Jack-liu1998/Non-contact-current-detector/TIM图片20180824213353.jpg

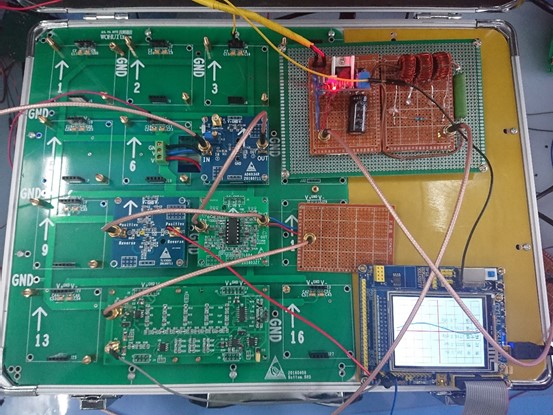
TIM图片20180824213353.jpg
