Jack-liu1998/Non-contact-current-detector/原理图/AD603原理图_v2.pdf

### 输出控制在0-1V

### 60MHz,40db，低噪声、宽增益可调集成运放

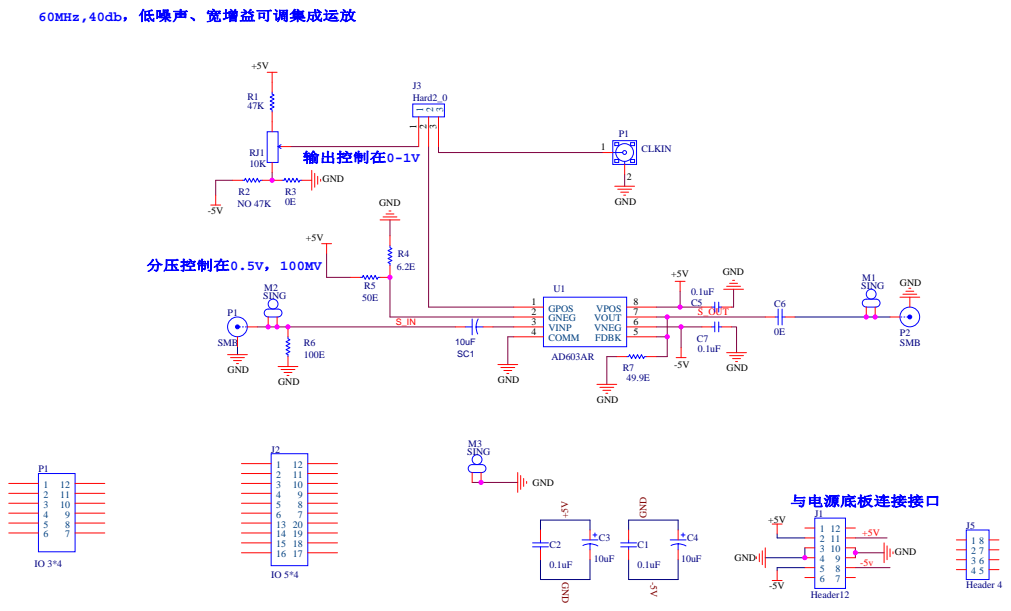
[picture p20: page 1]
