Jack-liu1998/Non-contact-current-detector/原理图/RC有源低通滤波器_TL084_工程文件.pdf

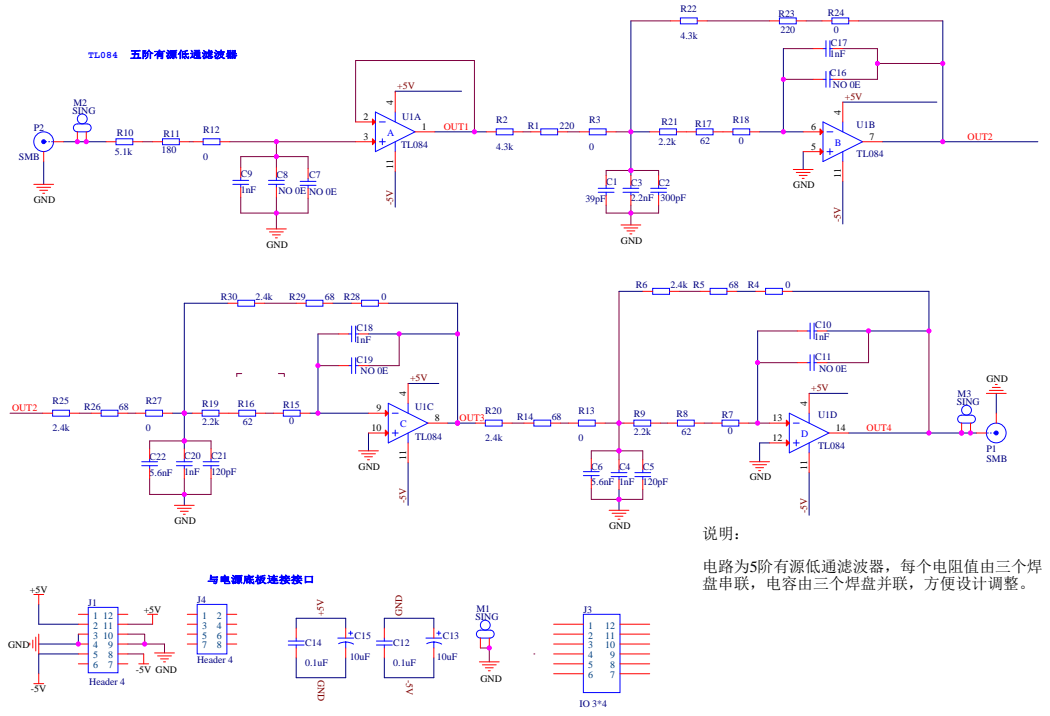
[picture p21: page 1]

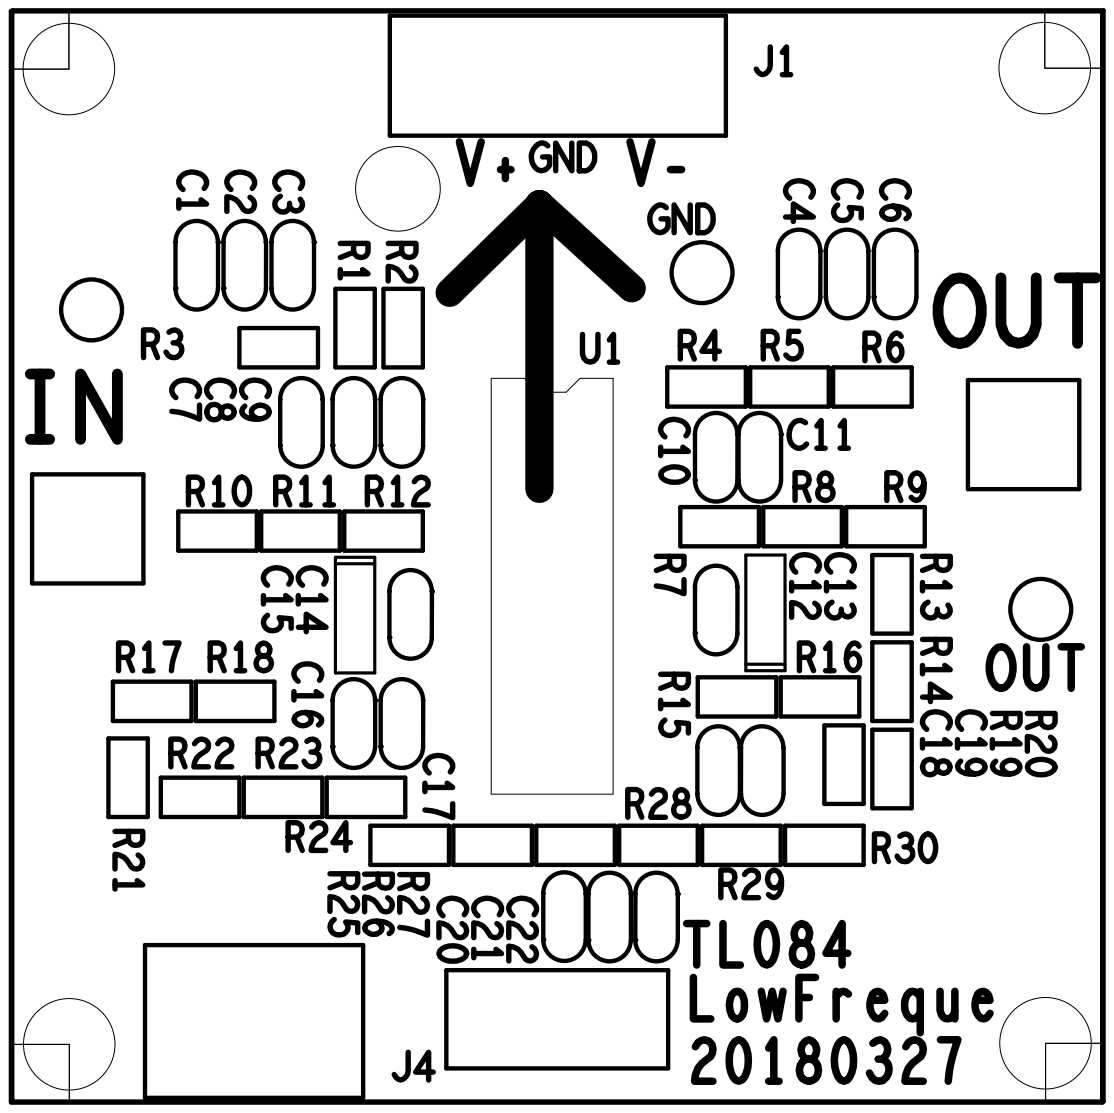
[picture p22: page 2]

封装 | 名称 | 数量 | 标号 | 备注
0805C | 39pF | 1 | C1
0805C | 300pF | 1 | C2
0805C | 2.2nF | 1 | C3
0805C | 1nF | 6 | C4;C9;C10;C17;C18;C20
0805C | 120pF | 2 | C5;C21
0805C | 5.6nF | 2 | C6;C22
0805C | 0 | 5 | C7;C8;C11;C16;C19 | 不焊
0805C | 0.1uF | 2 | C12;C14
0805R | 220 | 2 | R1;R23
0805R | 4.3k | 2 | R2;R22
0805R | 0 | 10 | R3;R4;R7;R12;R13;R15;R18;R24;R27;R28
0805R | 68 | 4 | R5;R14;R26;R29
0805R | 2.4k | 4 | R6;R20;R25;R30
0805R | 62 | 3 | R8;R16;R17
0805R | 2.2k | 3 | R9;R19;R21
0805R | 5.1k | 1 | R10
0805R | 180 | 1 | R11
3216T | 10uF | 2 | C13;C15
DIP4 | Header 4 | 1 | J4
DIP6 | Header 4 | 1 | J1
SMA-2 | SMB | 2 | P1;P2
TL084 | TL084 | 1 | U1
