Jack-liu1998/Non-contact-current-detector/原理图/stm32开发板.pdf

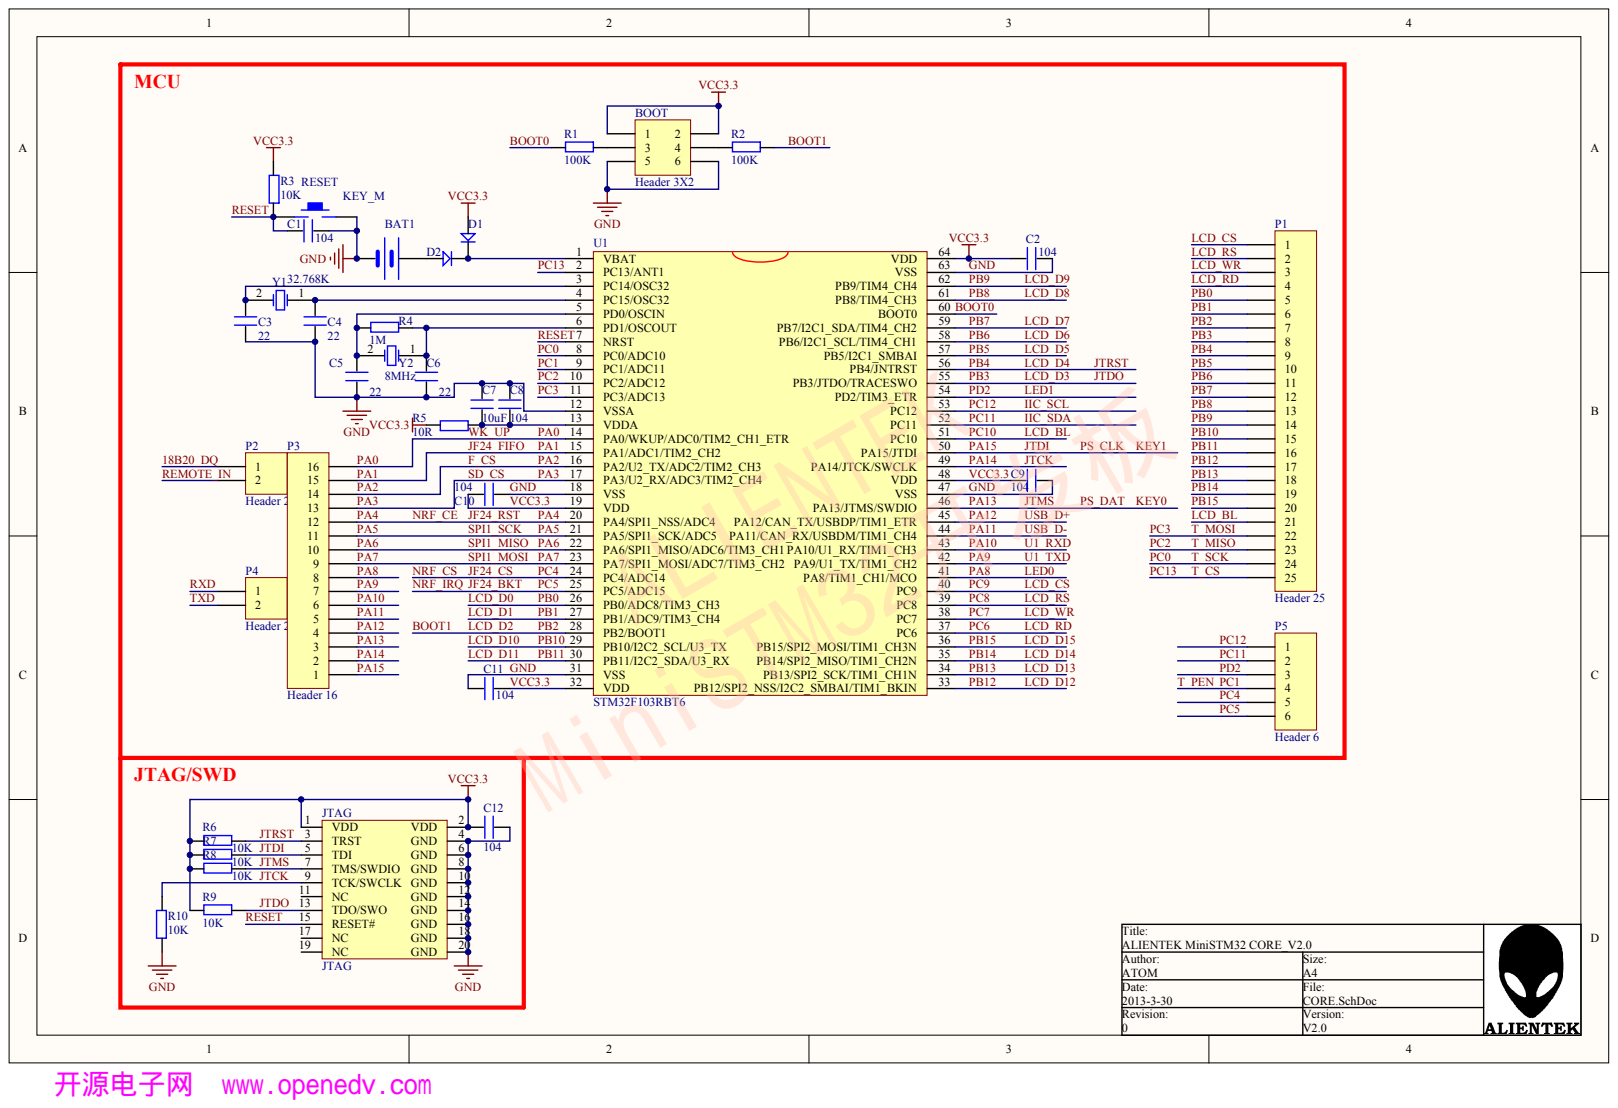
[picture p23: page 1]

PC15/OSC32 4

PD1/OSCOUT 6

8MHz | C6 | PC1/ADC11 9 PC2/ADC12 10 PC3/ADC13 11 VSSA 12

Author: ATOM | Size: A4

Date: 2013-3-30 | File: CORE.SchDoc

Revision: 0 | Version: V2.0

开源电子网 www.openedv.com

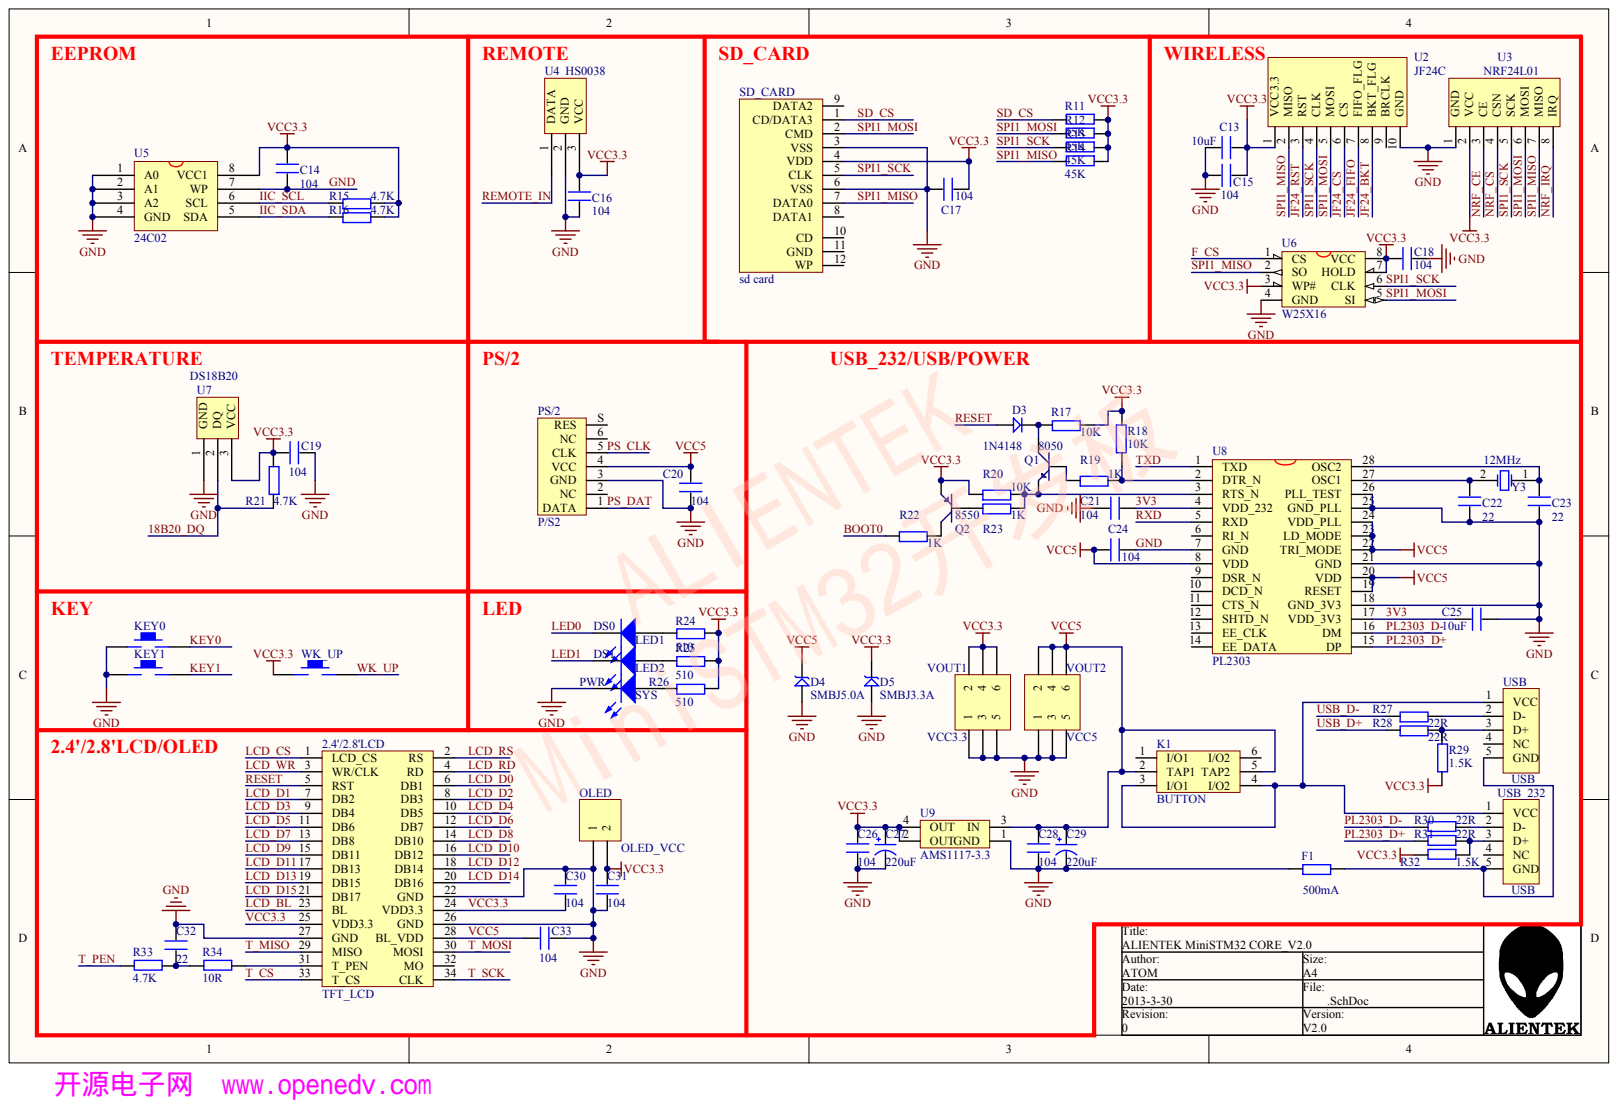
[picture p24: page 2]

SHTD_N 12 | 3V3 C25
EE_CLK 13 | PL2303_D-

Author: ATOM | Size: A4

Date: 2013-3-30 | File: .SchDoc

Revision: 0 | Version: V2.0

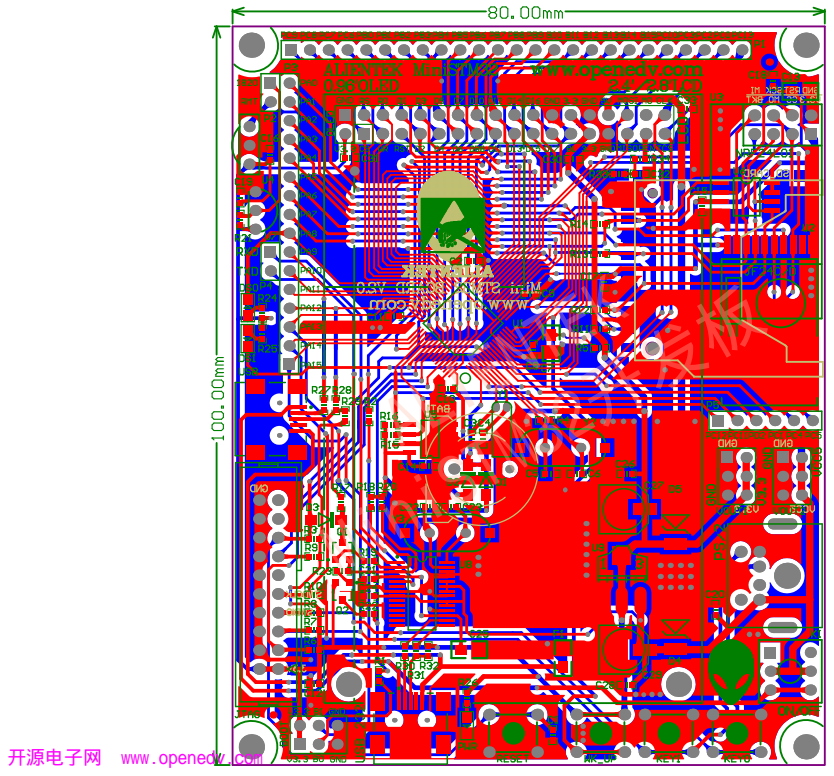
[picture p25: page 3]
