Jack-liu1998/Non-contact-current-detector/原理图/TDA2030.pdf

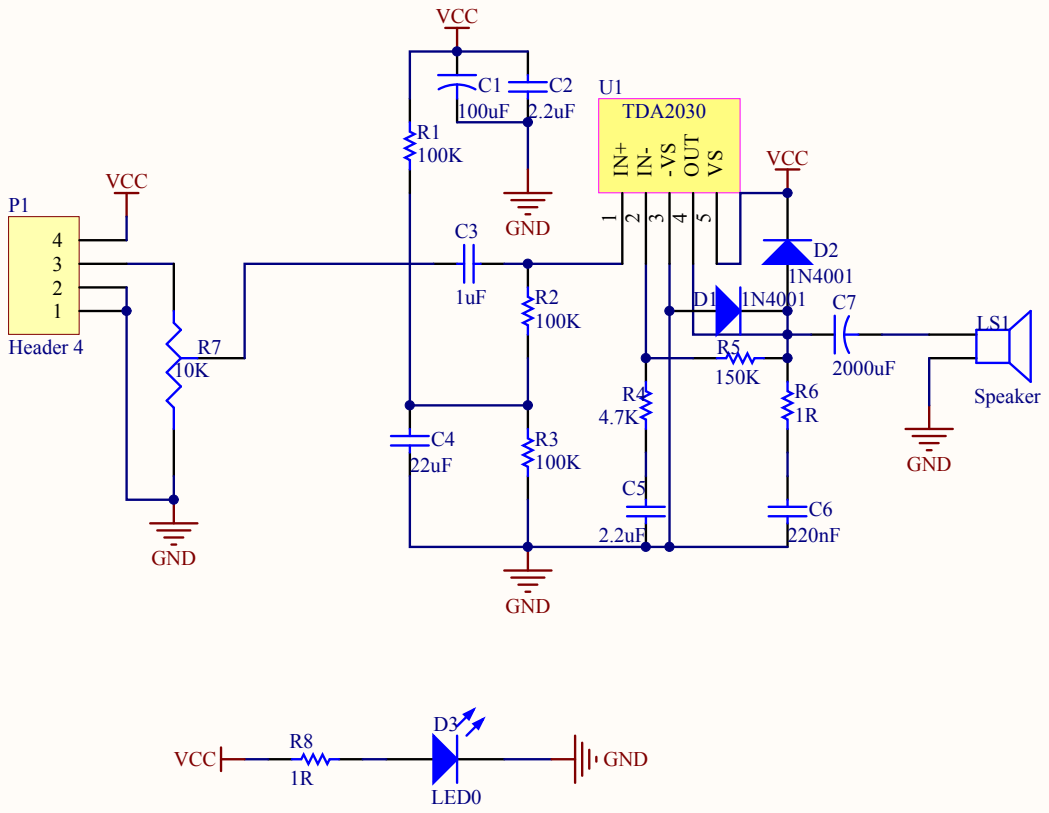
[picture p26: page 1]
