Jack-liu1998/Non-contact-current-detector/原理图/六、TLV3501电压比较器.pdf

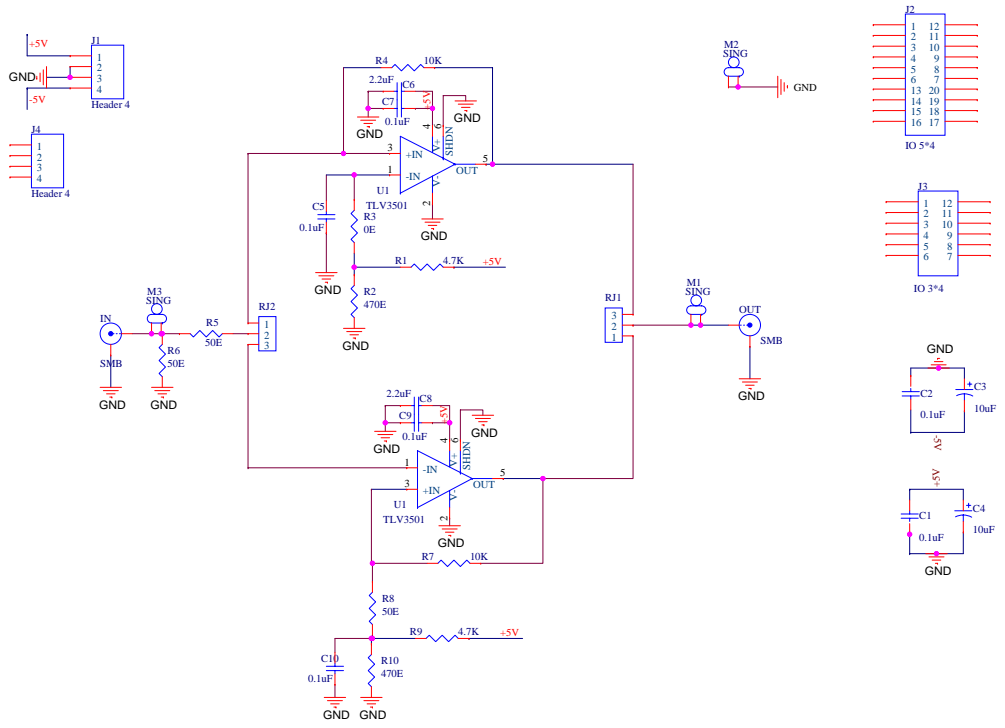
[picture p27: page 1]
