Jack-liu1998/Non-contact-current-detector/(list of files, drawings)

Other design files:
原理图/TDA2030仿真.ms13
