Jack-liu1998/Non-contact-current-detector/STM32_CODE/HARDWARE/DAC/dac.c

#include "dac.h"
#include "stm32f10x_dac.h"
#include "stm32f10x_dma.h"
#include "stm32f10x_tim.h"
#include "timer.h"

void Dac1_Init(void)
{
  
	GPIO_InitTypeDef GPIO_InitStructure;
	DAC_InitTypeDef DAC_InitType;

	RCC_APB2PeriphClockCmd(RCC_APB2Periph_GPIOA, ENABLE );	  //??PORTA????
  RCC_APB1PeriphClockCmd(RCC_APB1Periph_DAC, ENABLE );	  //??DAC???? 

	GPIO_InitStructure.GPIO_Pin = GPIO_Pin_4;				 // ????
 	GPIO_InitStructure.GPIO_Mode = GPIO_Mode_AIN; 		 //????
 	GPIO_InitStructure.GPIO_Speed = GPIO_Speed_50MHz;
 	GPIO_Init(GPIOA, &GPIO_InitStructure);
	GPIO_SetBits(GPIOA,GPIO_Pin_4)	;//PA.4 ???
					
	DAC_InitType.DAC_Trigger=DAC_Trigger_None;	//??????? TEN1=0
	DAC_InitType.DAC_WaveGeneration=DAC_WaveGeneration_None;//???????
	DAC_InitType.DAC_LFSRUnmask_TriangleAmplitude=DAC_LFSRUnmask_Bit0;//???????
	DAC_InitType.DAC_OutputBuffer=DAC_OutputBuffer_Disable ;	//DAC1?????? BOFF1=1
  DAC_Init(DAC_Channel_1,&DAC_InitType);	 //???DAC??1

	DAC_Cmd(DAC_Channel_1, ENABLE);  //??DAC1
  
  DAC_SetChannel1Data(DAC_Align_12b_R, 0);  //12??????????DAC?

}

//????1????
//vol:0~3300,??0~3.3V
void Dac1_Set_Vol(u16 vol)
{
	float temp=vol;
	temp/=1000;
	temp=temp*4096/3.3;
	DAC_SetChannel1Data(DAC_Align_12b_R,temp);//12??????????DAC?
}
