Jack-liu1998/Non-contact-current-detector/STM32_CODE/HARDWARE/DAC/dac.h

#ifndef __DAC_H
#define __DAC_H
#include "sys.h"

//typedef struct DAC_WAVE
//{
//    uint32_t HZ;//5-281250
//    uint16_t DC_value;
//    uint16_t Amplitude;//幅度
//    uint16_t* WAVE_P;//波形指针
//} DAC_WAVE_Typedef;


void Dac1_Init(void);//???????		 	 
void Dac1_Set_Vol(u16 vol);
#endif
