Jack-liu1998/Non-contact-current-detector/(notices)

Notices in the files:
STM32_CODE/HARDWARE/LCD/lcd.c:
Copyright(C) ¹ãÖÝÊÐÐÇÒíµç×Ó¿Æ¼¼ÓÐÏÞ¹«Ë¾ 2014-2024
All rights reserved
STM32_CODE/SYSTEM/USMART/usmart.c:
Copyright(C) ÕýµãÔ­×Ó 2011-2021
STM32_CODE/HARDWARE/EXTI/exti.c:
Copyright(C) ÕýµãÔ­×Ó 2009-2019
STM32_CODE/HARDWARE/KEY/key.c:
Copyright(C) ¹ãÖÝÊÐÐÇÒíµç×Ó¿Æ¼¼ÓÐÏÞ¹«Ë¾ 2009-2019
